flowing-wind/SPI_Slave/tb/README

To perform gate-level sim, copy _lvs.v and _minmax.sdf into current directory.
