flowing-wind/SPI_Slave/doc/SPI_Slave_Design.pptx

## SPI Slave Design

BY Eric Yang 2026.08

## Overview

- Features
  - CPOL=0, CPHA=0
  - MSB first
  - Back-to-back transfer support
  - 8 x 16-bit registers available
  - Read data within the same frame
  - No system clock
  - 24-bit self-defined frame protocol
- Frame Structure (MSB first)
  - [23] RW 0 = write, 1 = read
  - [22:16] ADDR only the low AW bits are decoded, upper bits ignored
  - [15:0] DATA

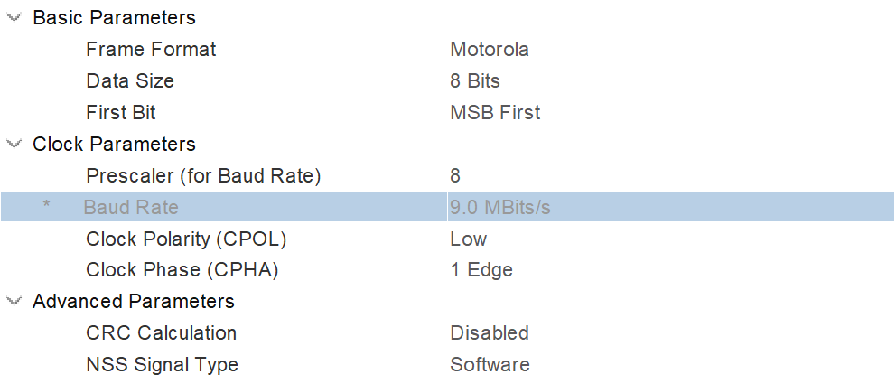
[picture p1: figure]

Easy to communicate with MCU using an 8-bit SPI peripheral.
3 Back-to-back transfers per frame with software NSS control.

## Front-end Design

No system clock:
- No CDC problem

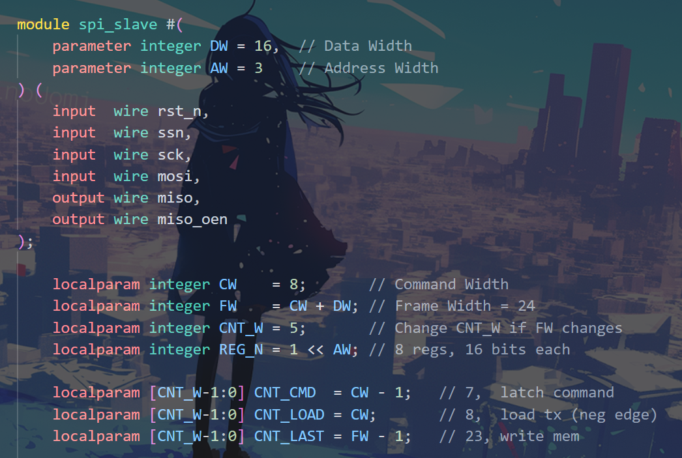
[picture p2: figure]

Design is parameterized –
Easy to customize the frame format,
or modify the number of registers.

SPI Slave Block Diagram

## RTL Simulation

- Simulator: VCS
- Testbench Language: SystemVerilog
- Verification tasks:
  - Reset behavior
  - All zeros/ones transfer
  - Back-to-back transfer
  - Read/Write same addr
  - Read/Write when deselected
  - Randomized multi-frame transfer
  - Functional coverage

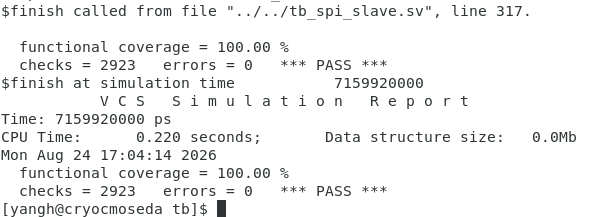
[picture p3: figure]

## Coverage Report

- Functional Coverage
  - Cover both read and write
  - Cover all 8 regs
  - Cover arbitrary addr_hi
  - Cover data with boundary conditions
  - (Cross Cover) All regs should be both read and written
- Line/Cond/Toggle/Branch Coverage
  - All 100% in VCS coverage report

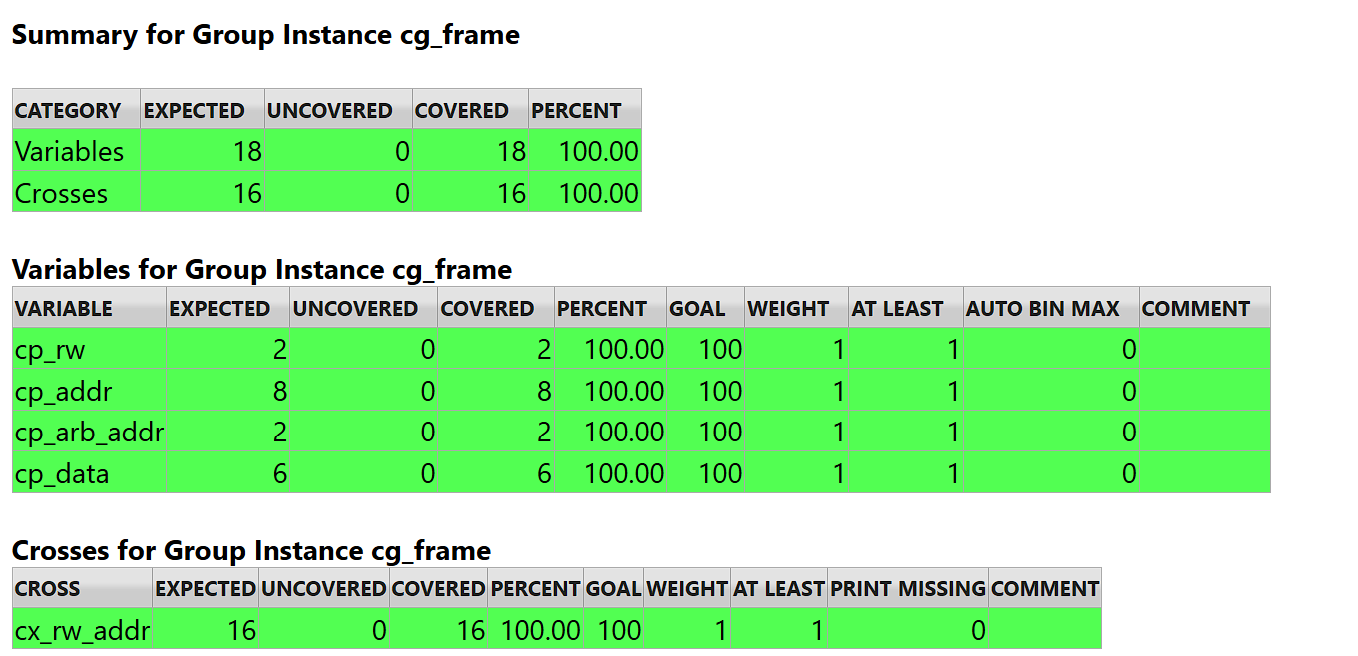
[picture p4: figure]
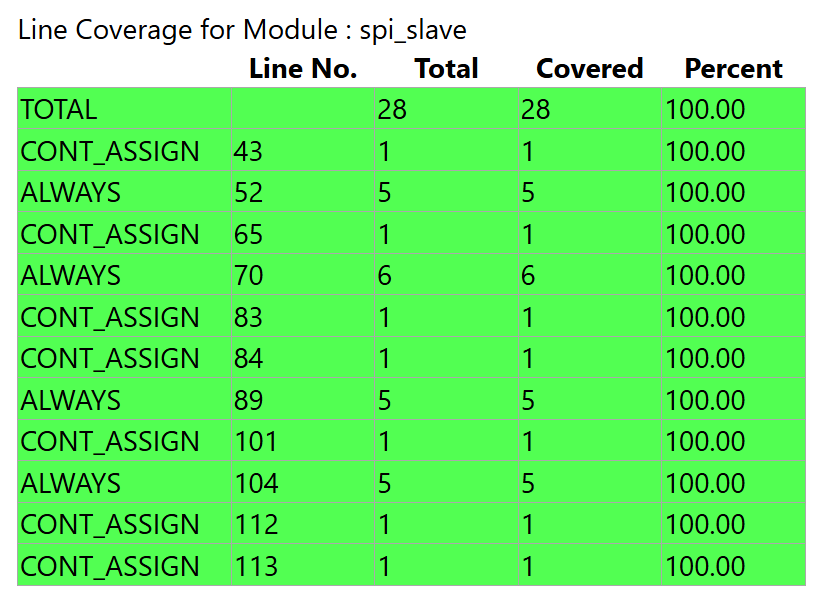
[picture p5: figure]
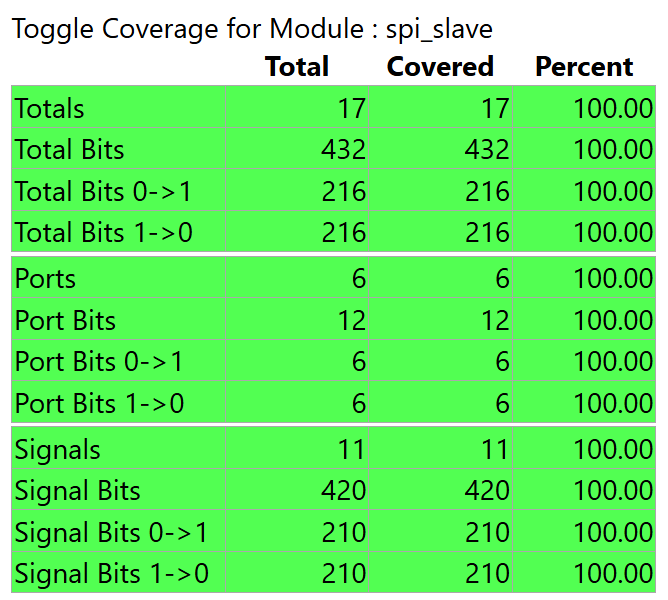
[picture p6: figure]
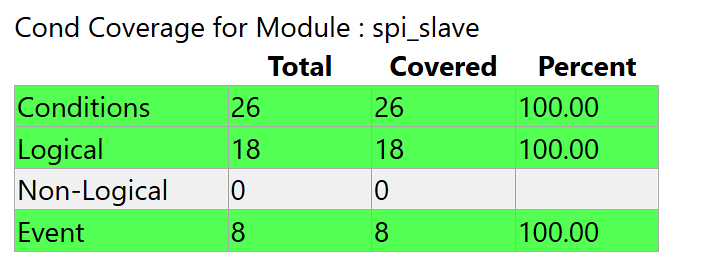
[picture p7: figure]
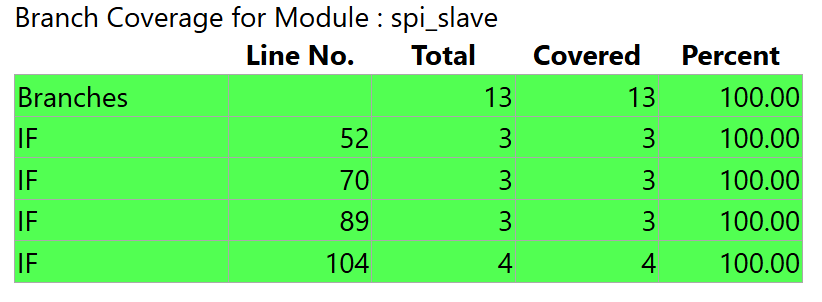
[picture p8: figure]

## Waveforms of Transfers

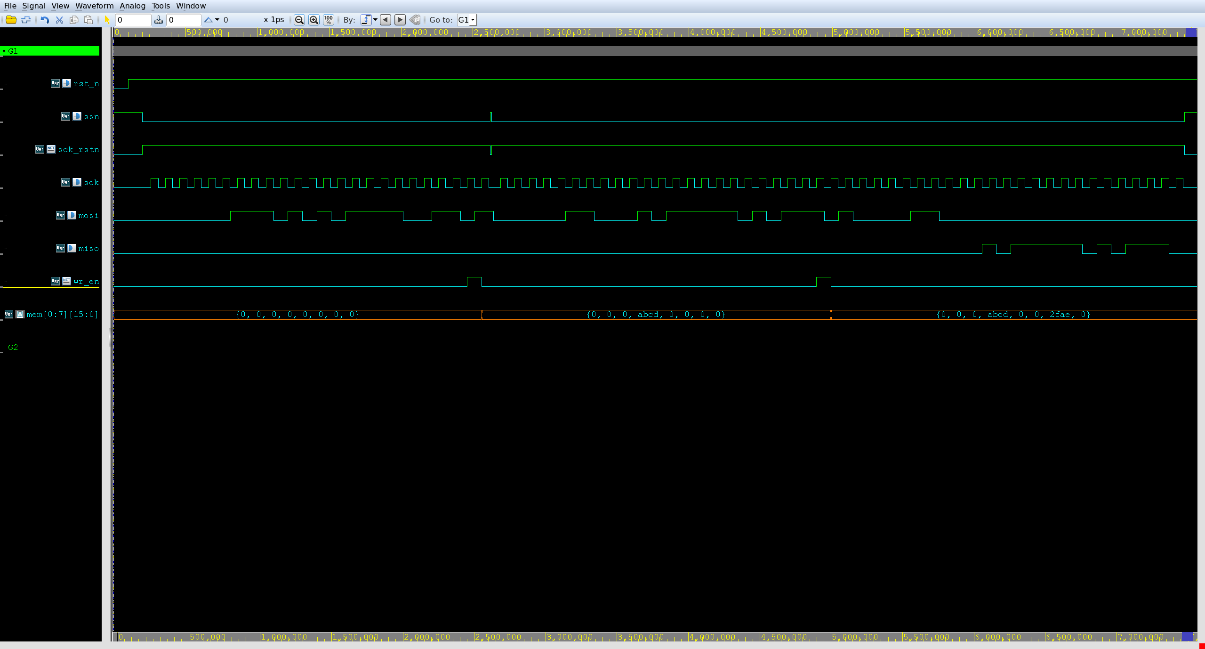
[picture p9: figure]

Read Command

Data Received

Read from 7’d6

Write 16’hABCD to 7’d3

Write 16’h2FAE to 7’d6

Back-to-back transfer

## Back-end Design

- Constraints (Without IO)
  - Clock Frequency: 10MHz
  - Clock Uncertainty: ~10% T
  - Clock Transition: 0.3ns
  - Duty Cycle 60% (60% High, 40% Low)
  - Input/Output delay:
    - Max (setup): Assume 50% CLK_LOW for setup
    - Min (hold): No requirement as a half-cycle remains before sampling
  - Max Fanout: 20

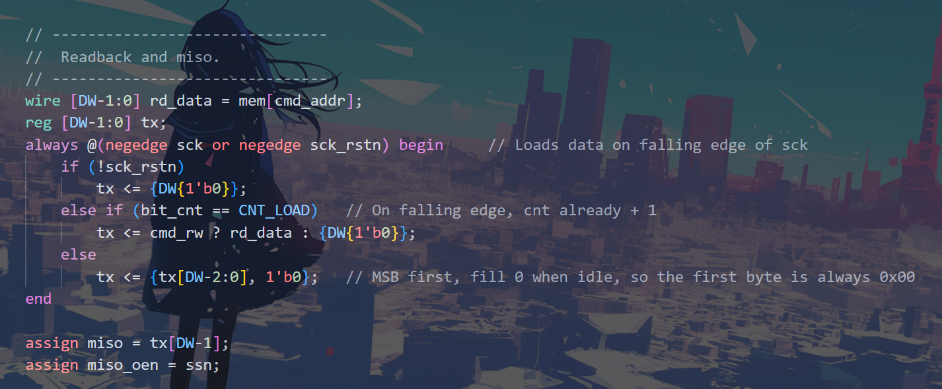
[picture p10: figure]

Data is transmitted at negedge,
but sampled at posedge.
Critical path for output delay (setup).

## DC & FM

- DC Summary
  - No Violation
  - Area: 12014.33 um²
- FM Summary
  - No LAT
  - Verification Succeeded

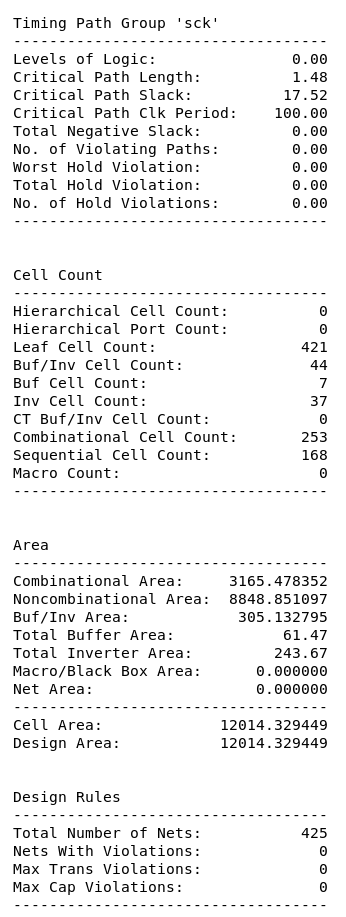
[picture p11: figure]
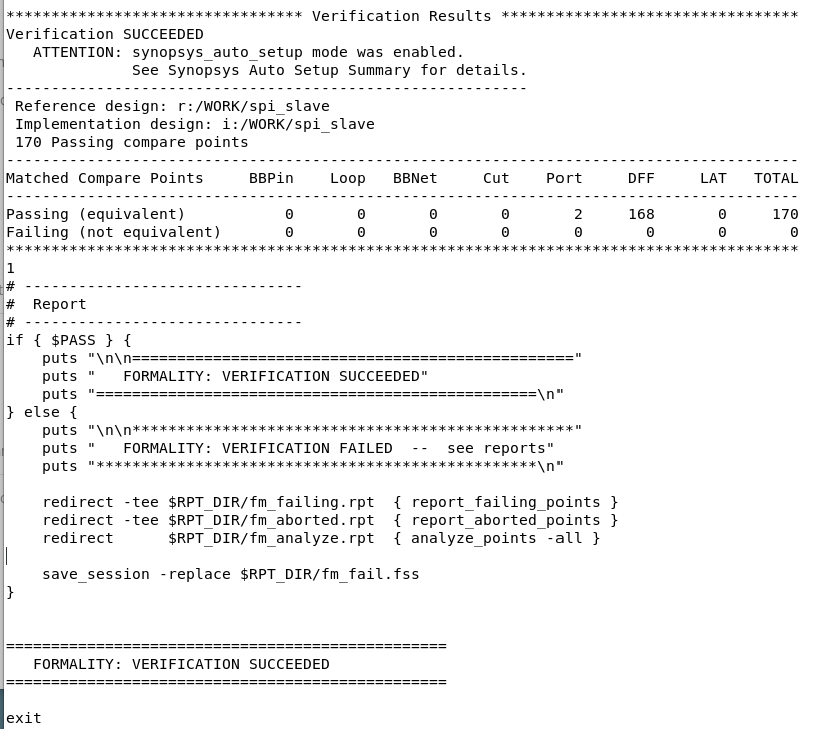
[picture p12: figure]

## Innovus

- Process: TSMC 0.18um
- LIB: tcb018gbwp7t
  - WC: SS/125℃/1.62V for setup
  - BC: FF/ 0℃ / 1.98V for hold
- FloorPlan
  - Die: 294um * 98um
    - DIE_W = 294 = core 270 + 2 x 12 margin
    - DIE_H = 98 = core 80 + 2 x 9 margin
  - Pins: {miso miso_oen mosi sck ssn rst_n}

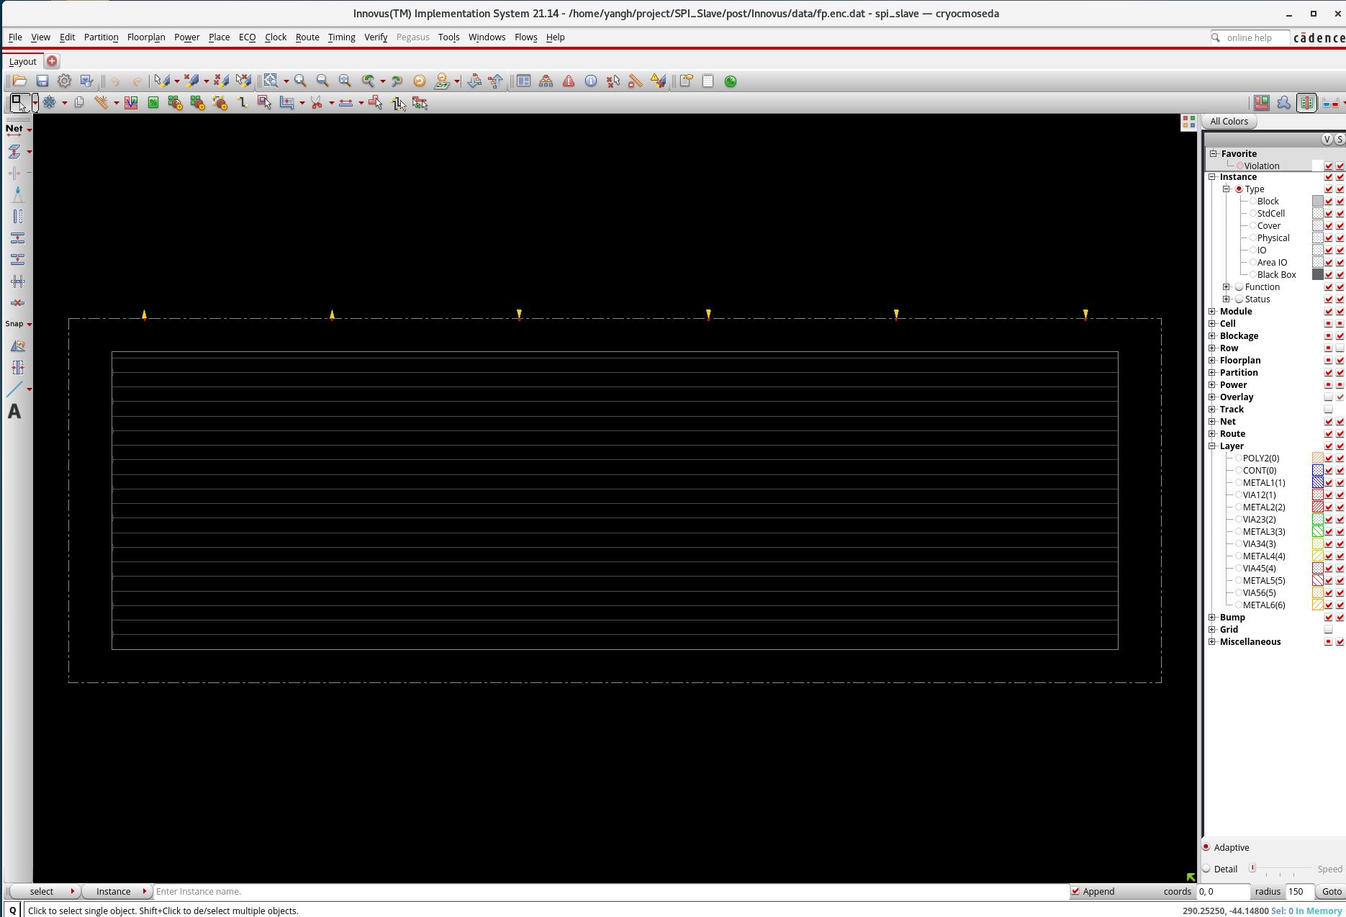
[picture p13: figure]

## Innovus

- Power
  - Power Ring
    - Metal 6 Vertical
    - Metal 5 Horizontal
  - Power Stripe
    - Metal 6 Vertical
    - 4 sets
  - Power Rail
    - Metal 1 Horizontal

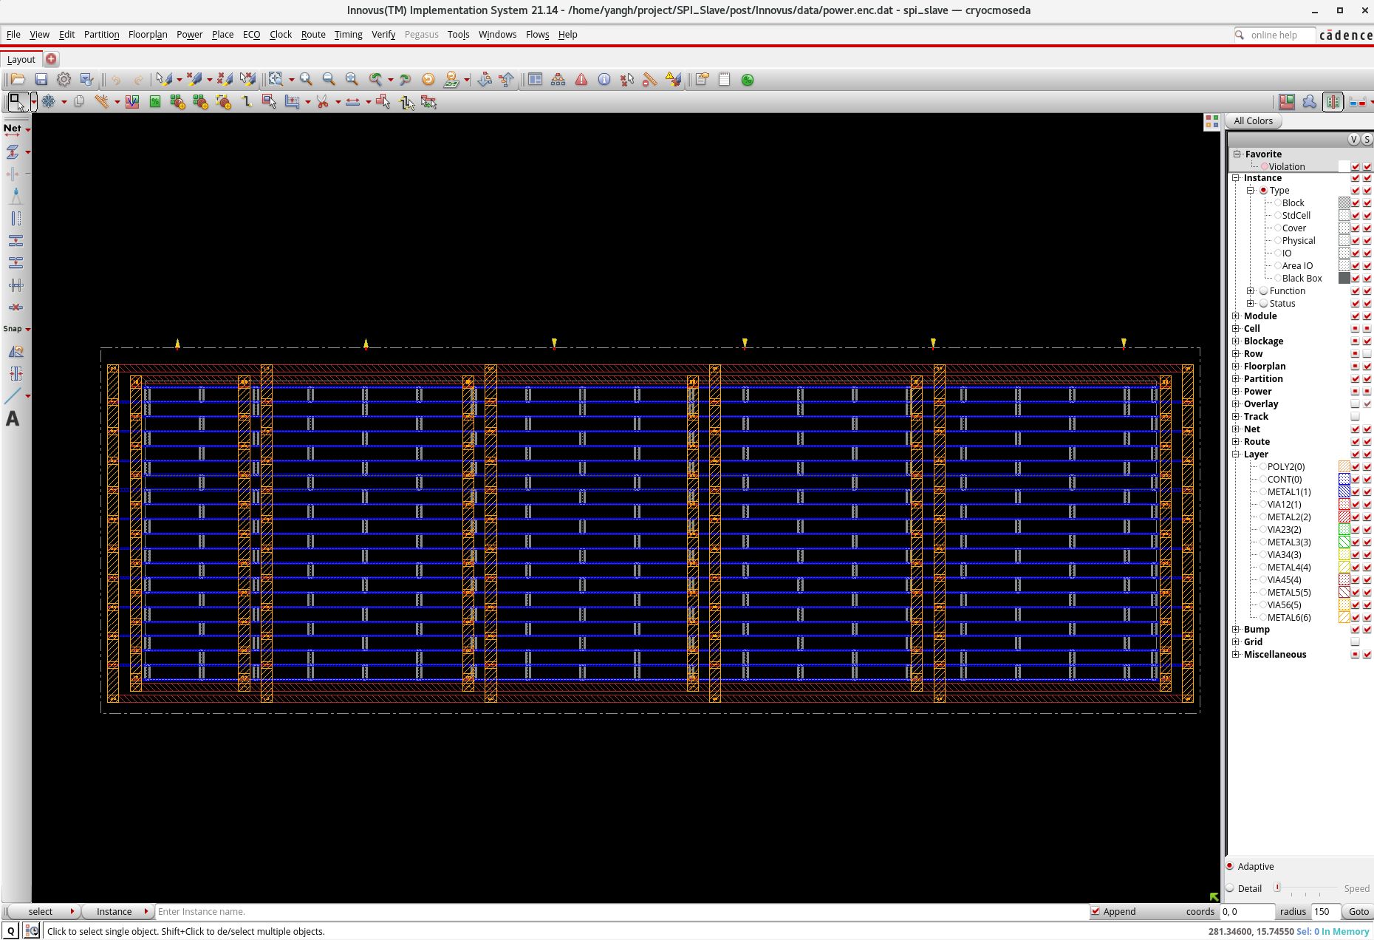
[picture p14: figure]

## Innovus

- Summary
  - Density: 67.928%
    - 100.000% with Fillers
  - Total number of glitch violations: 0

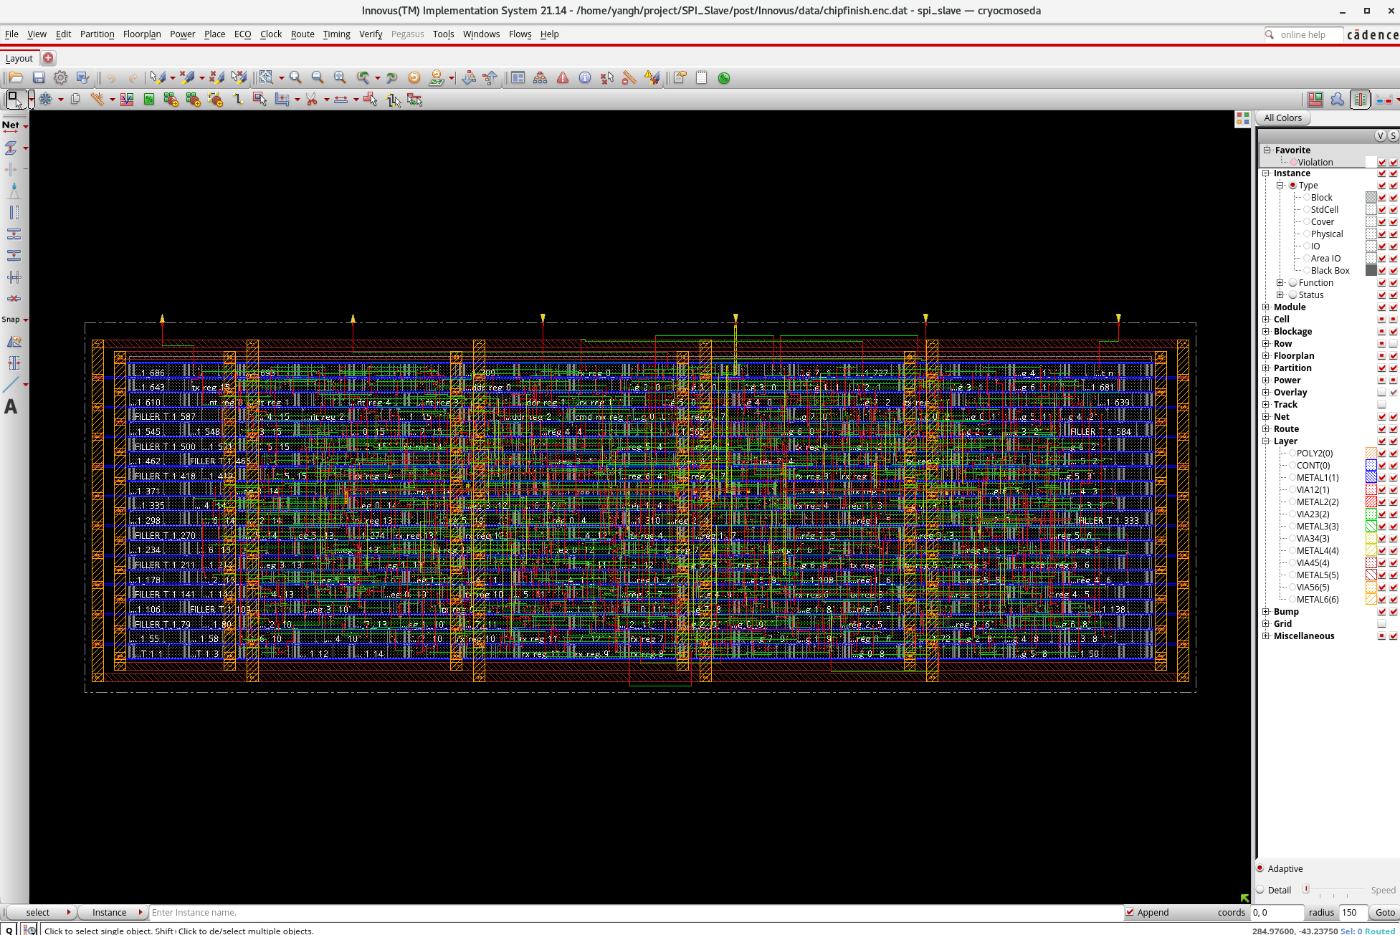
[picture p15: figure]
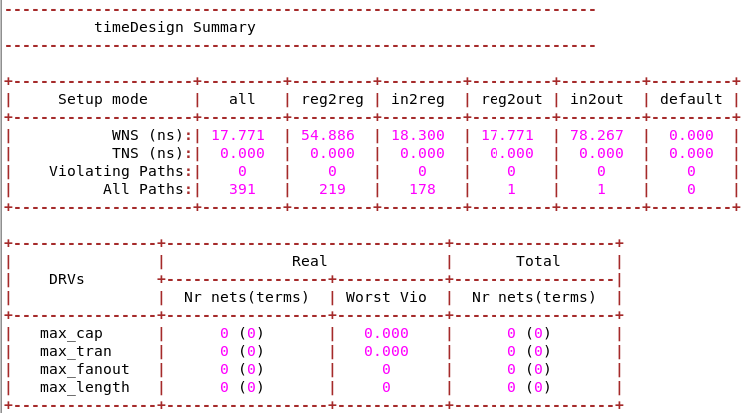
[picture p16: figure]
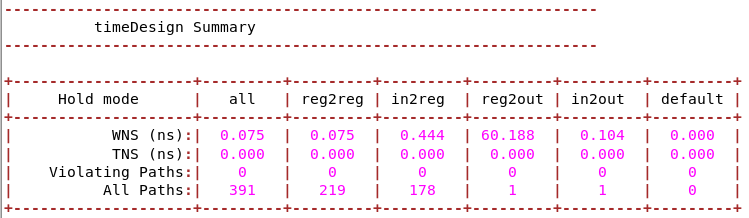
[picture p17: figure]

## IO Plan

- Power IO
  - Pre-drivers & Core
    - 1.8V
  - Post-drivers
    - 3.3V
    - We take PVDD2POC as the
post-driver power supply
  - Power On Control
    - Will explain later

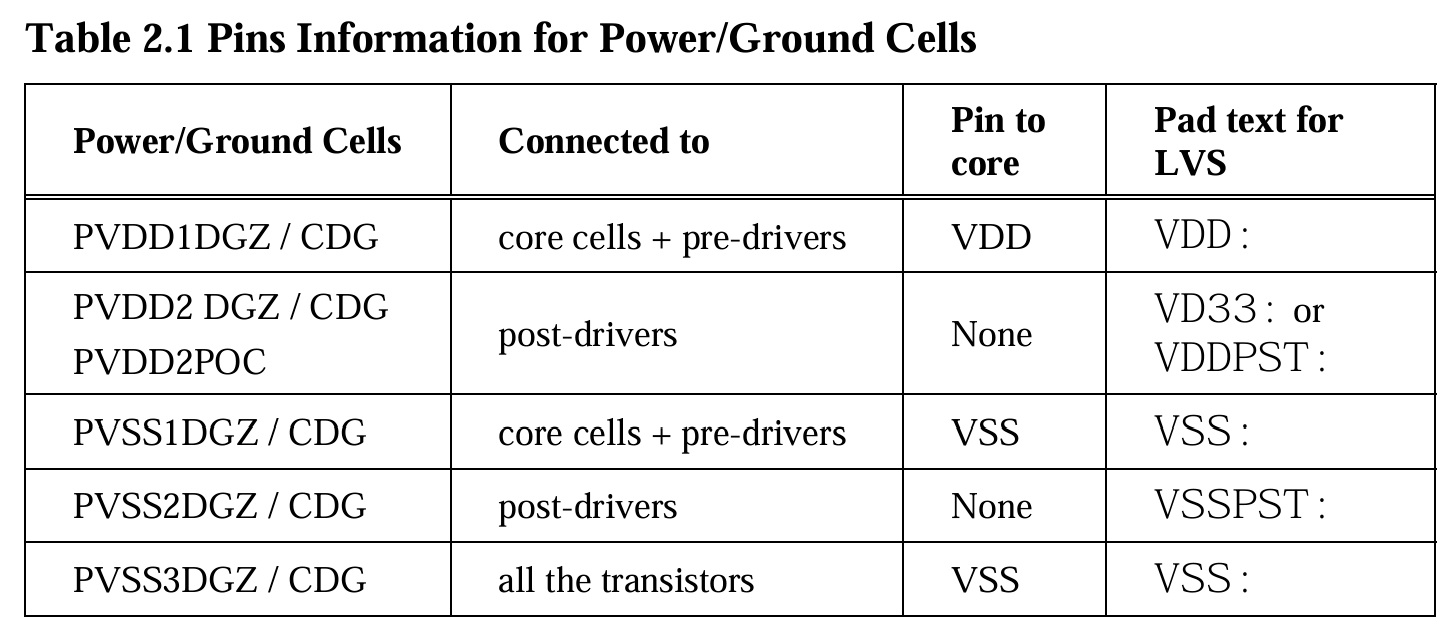
[picture p18: figure]
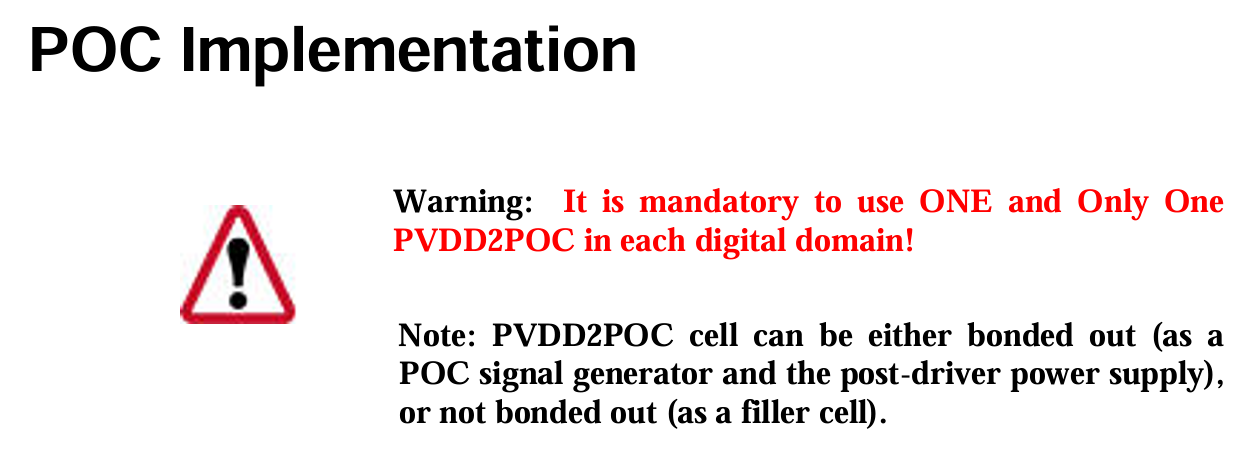
[picture p19: figure]

## IO Plan

- Digital IO
  - Input (PRXW0812SCDG)
    - Pull-up: rst_n, ssn
    - Pull-down: sck, mosi
    - Schmitt Trigger Input
      - For noise immunity
  - Output
    - PRDW0812SCDG
    - With Slew Rate Controlled Output
      - Reduce peak current
    - 8mA output
      - ~7ns edge @20pF, 3.3V

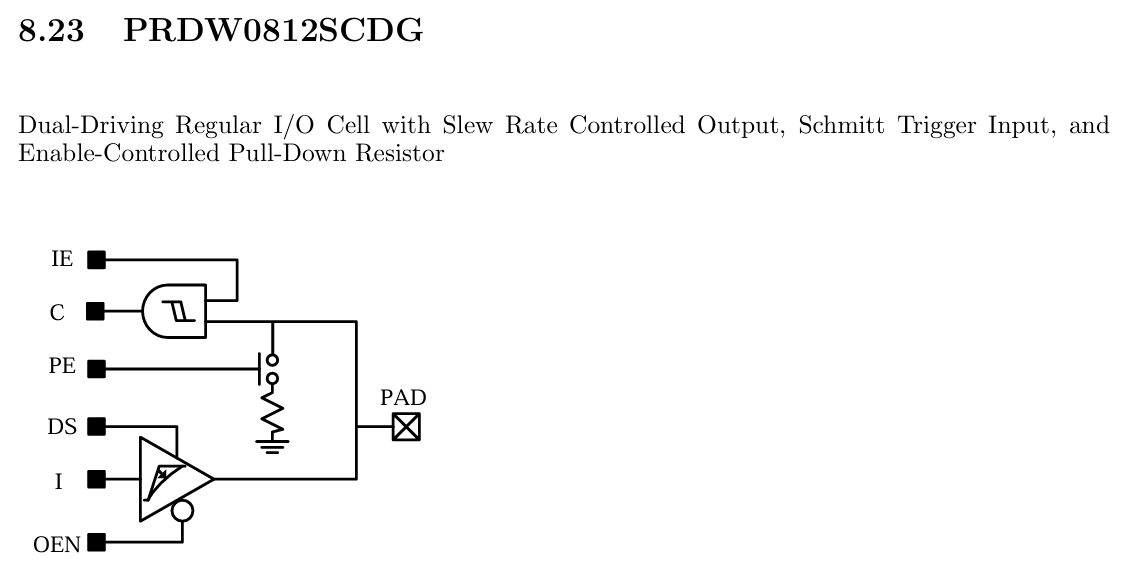
[picture p20: figure]
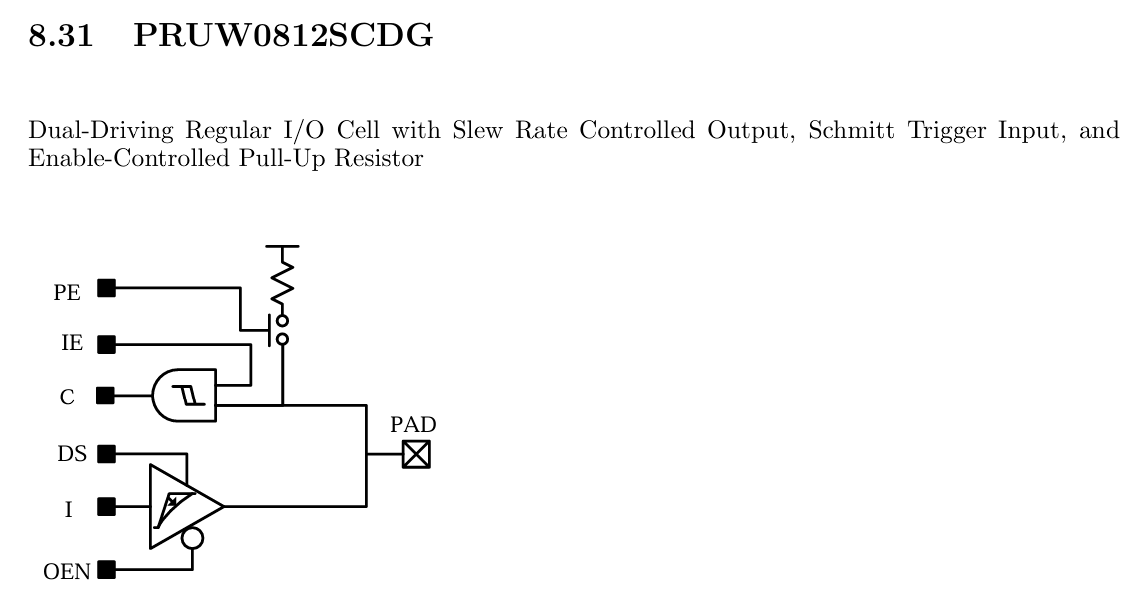
[picture p21: figure]

## Virtuoso Layout

My Part

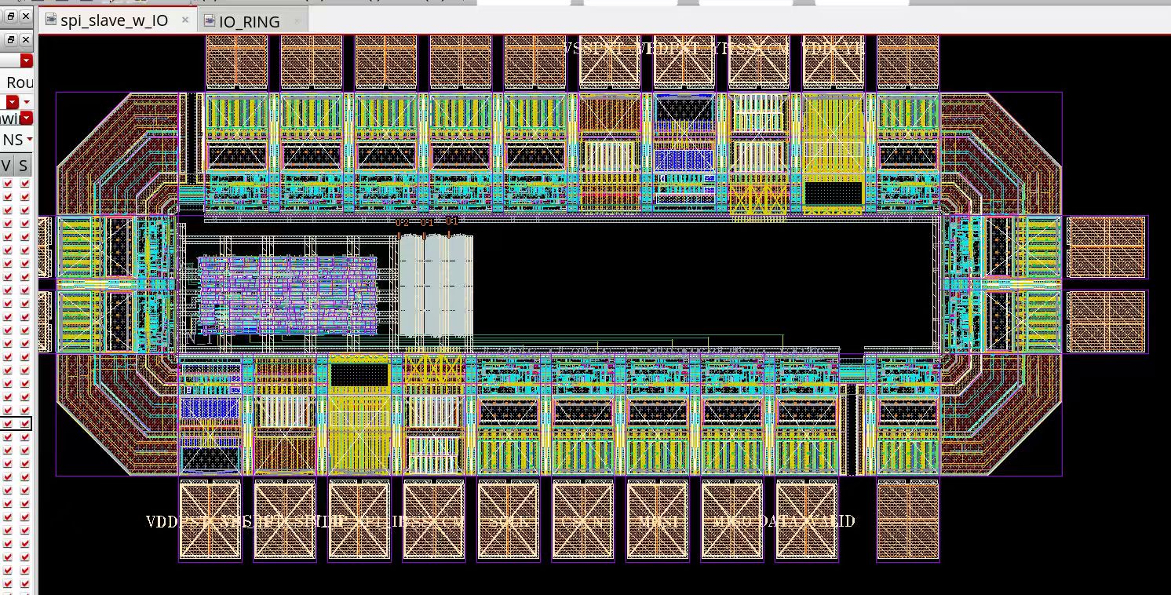
[picture p22: figure]

## Virtuoso Layout

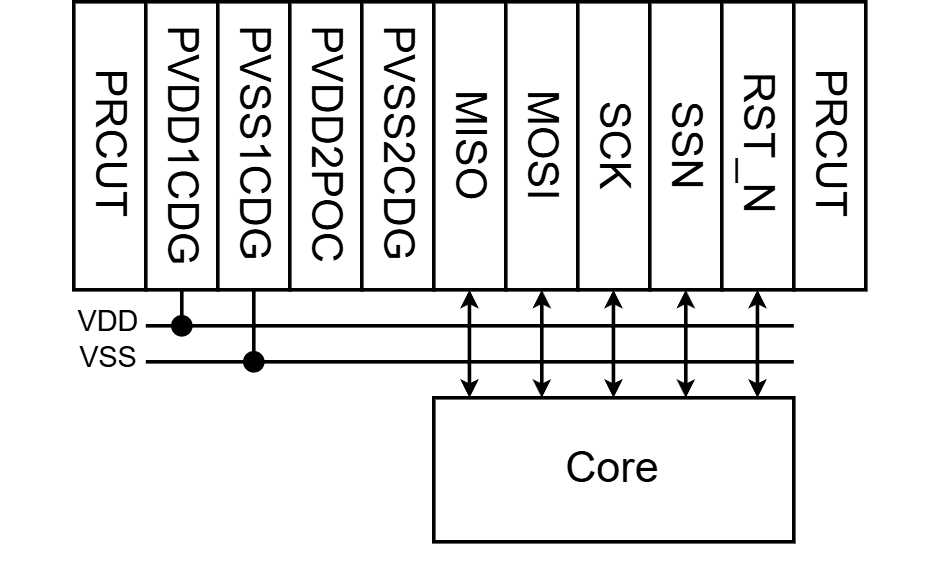
[picture p23: figure]
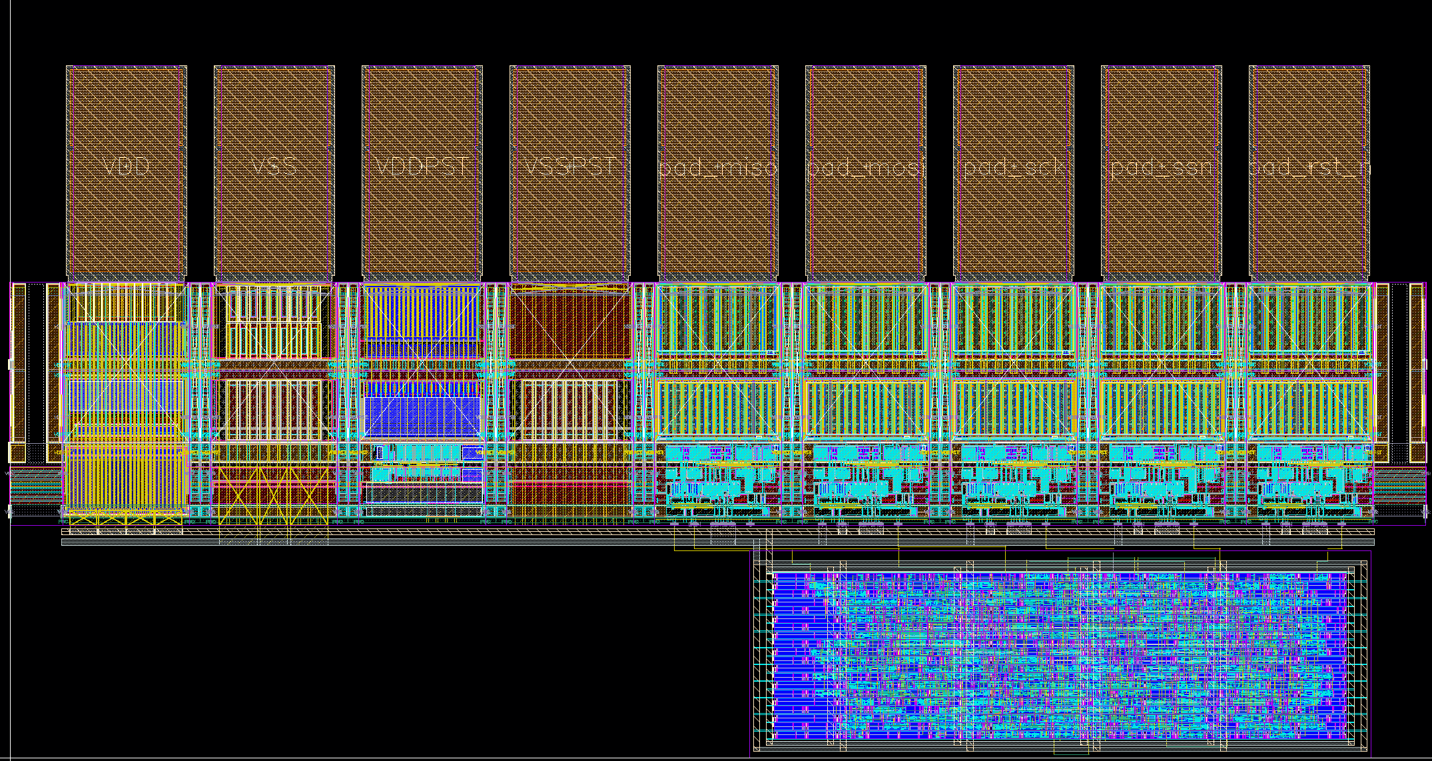
[picture p24: figure]

## LVS & DRC

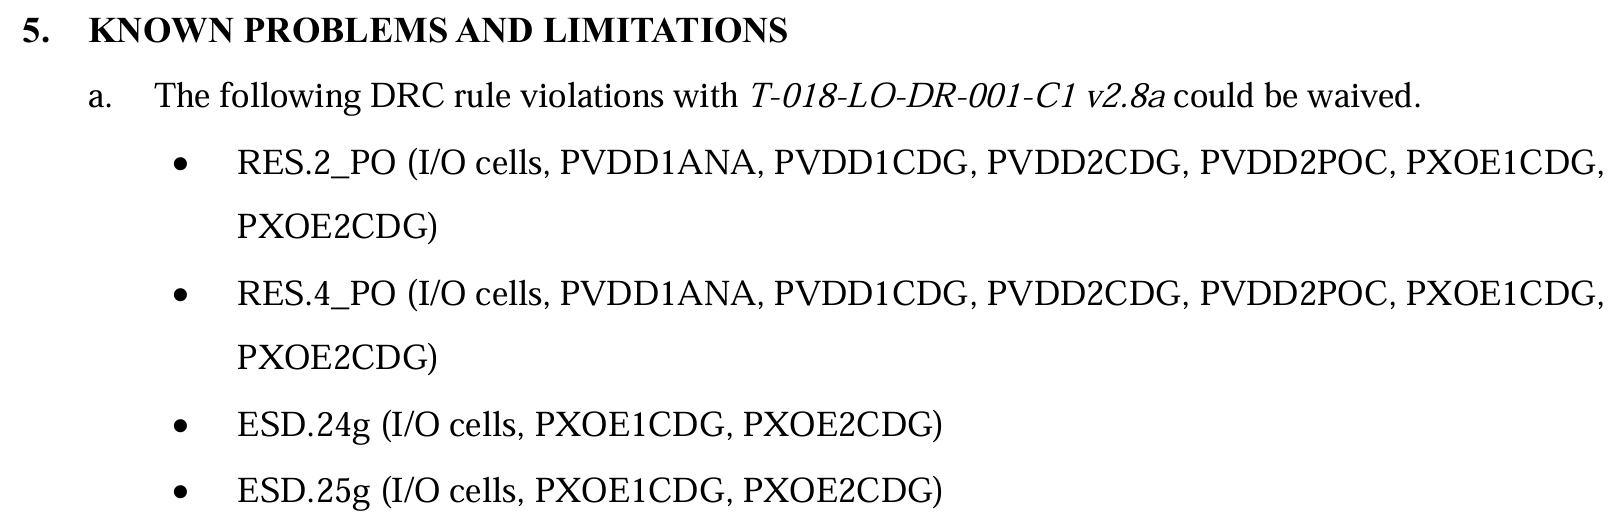
[picture p25: figure]
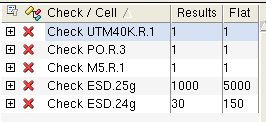
[picture p26: figure]

- LVS
  - All passed
- DRC
  - UTM40K.R.1 { @ Min. density of M6 area >= 30% }
    - Dummy fill by others
  - PO.R.3 { @ Min poly area coverage < 14% }
    - Dummy fill by others
  - M5.R.1 { @ Min M5 area coverage < 30%}
    - Dummy fill by others
  - ESD.24g & ESD.25g
    - Waived due to rn_tpd018nv_280a.pdf

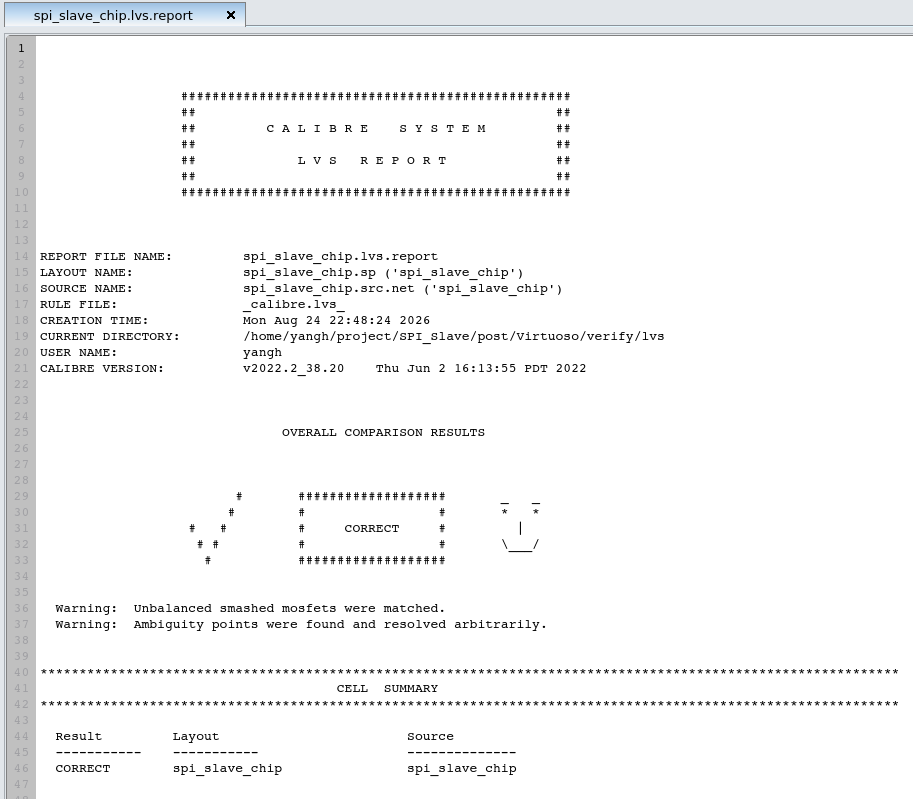
[picture p27: figure]

## Gate-level Simulation

- Simulator: VCS
- Testbench Language: SystemVerilog
- Same tasks with SDF annotation
- Max/Min all passed

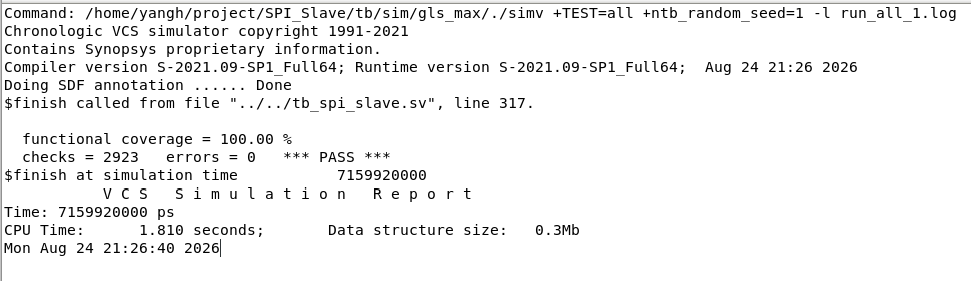
[picture p28: figure]
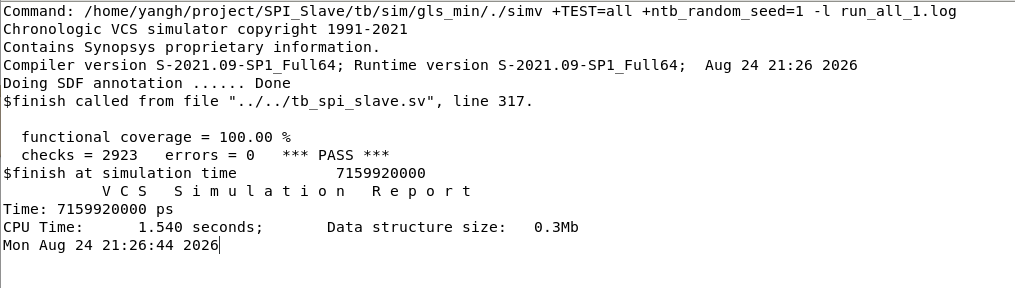
[picture p29: figure]

## Post-layout Simulation

- POC test
- Why POC?
  - The power-up sequence between rails is not guaranteed
  - It is common for the IO supply (3.3 V) to come up before the core supply (1.8 V)
  - POC is required to clamp the IO into a known state (typically high-Z) until the core supply is stable

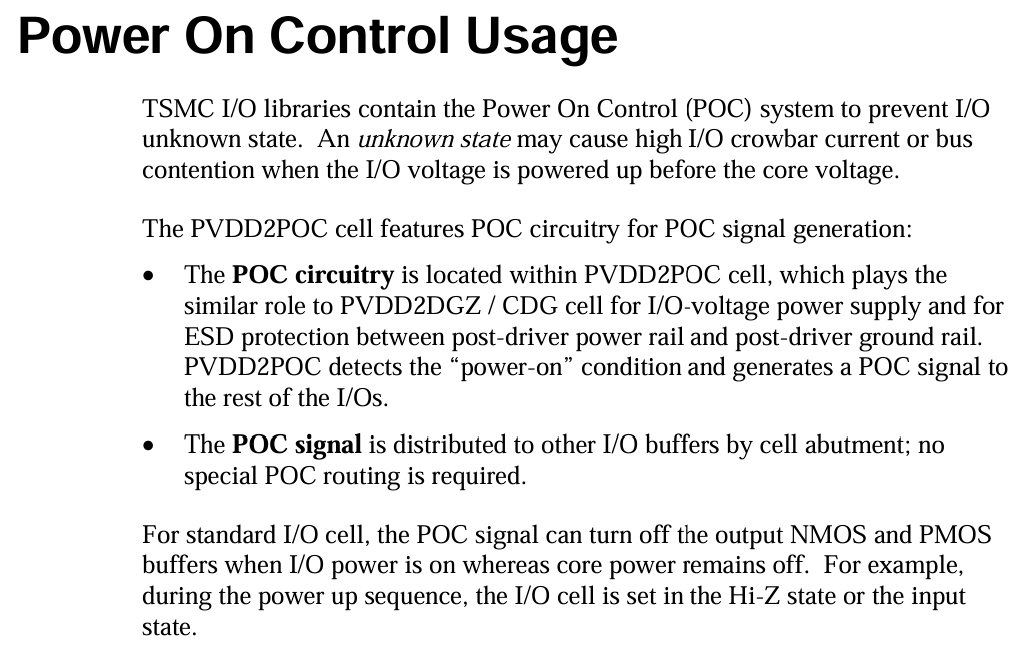
[picture p30: figure]
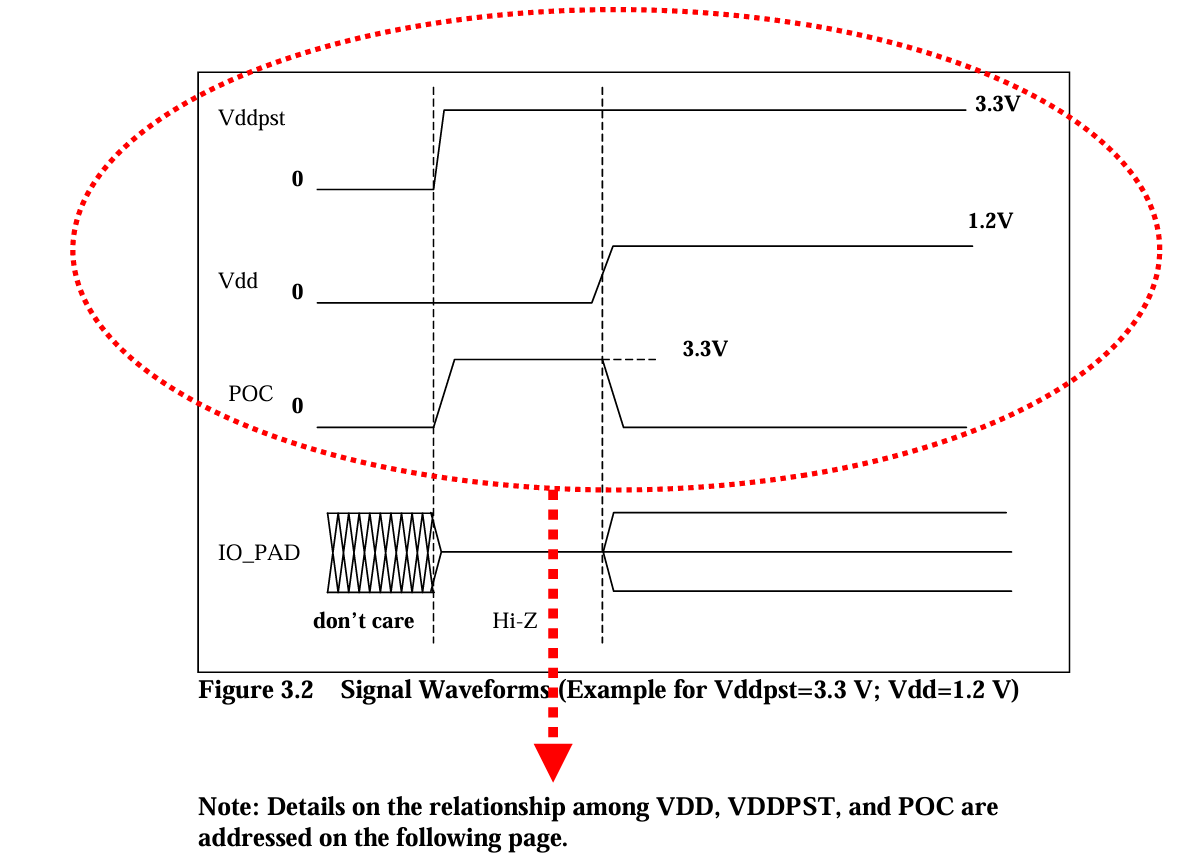
[picture p31: figure]
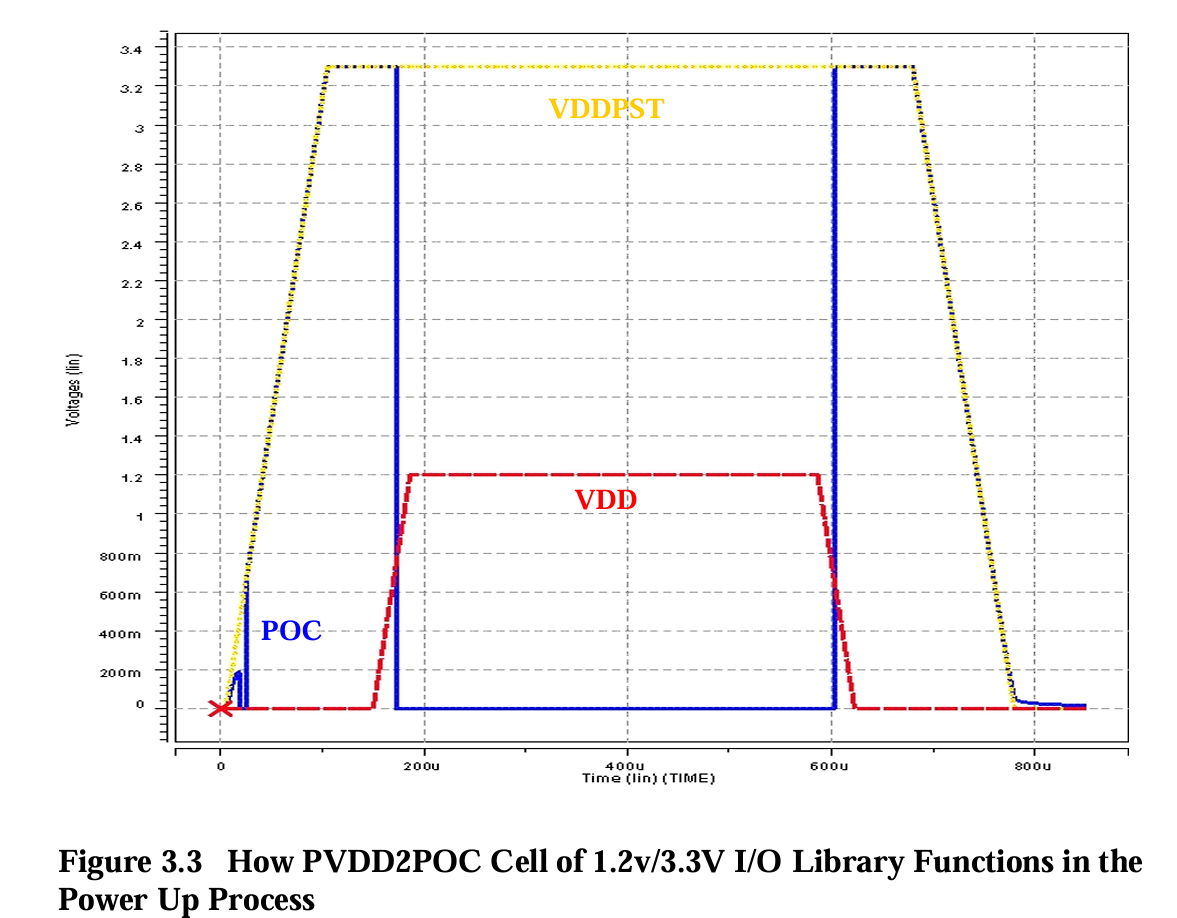
[picture p32: figure]

## POC Test

- How to test high-Z:
  - Connect IO to 1.65V with 1M resistor
  - If pad is high-Z,
it’ll be clamped at 1.65V
  - If pad is controlled by the core,
it’ll be either near 3.3V / 0V

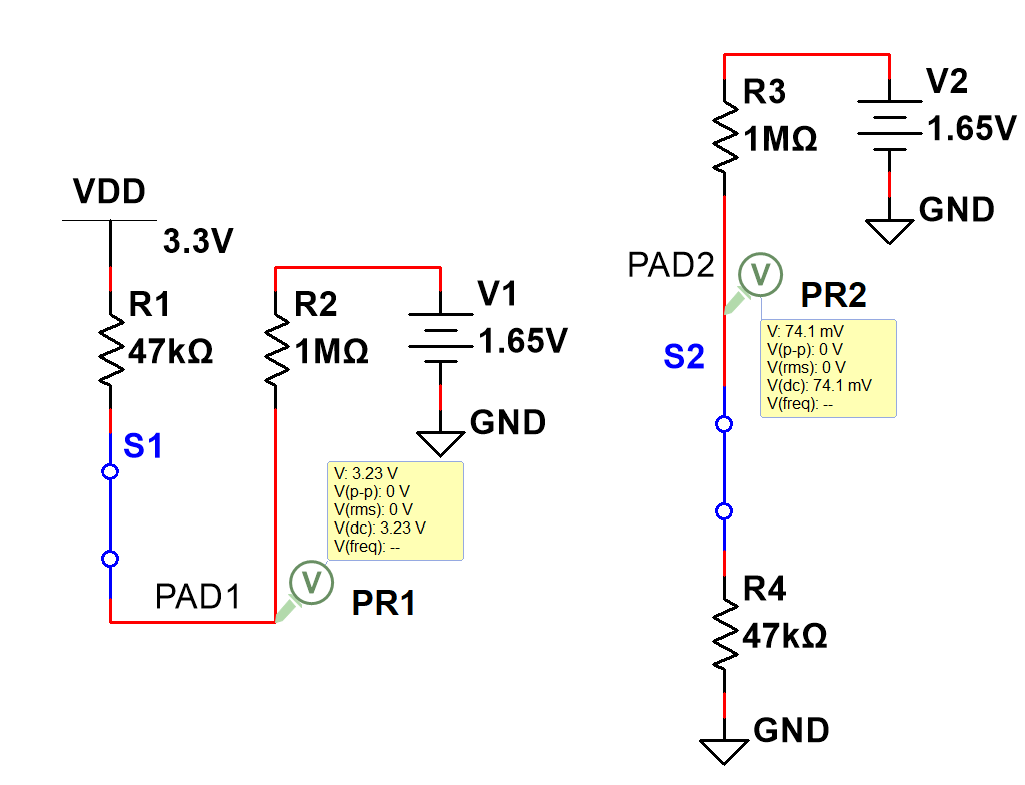
[picture p33: figure]
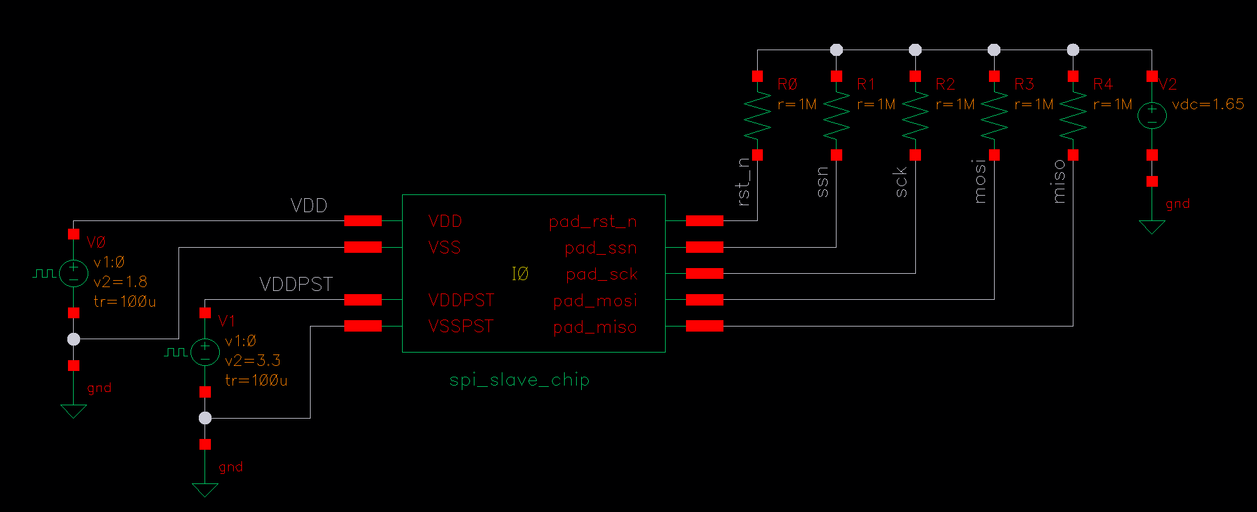
[picture p34: figure]

## Slide 20

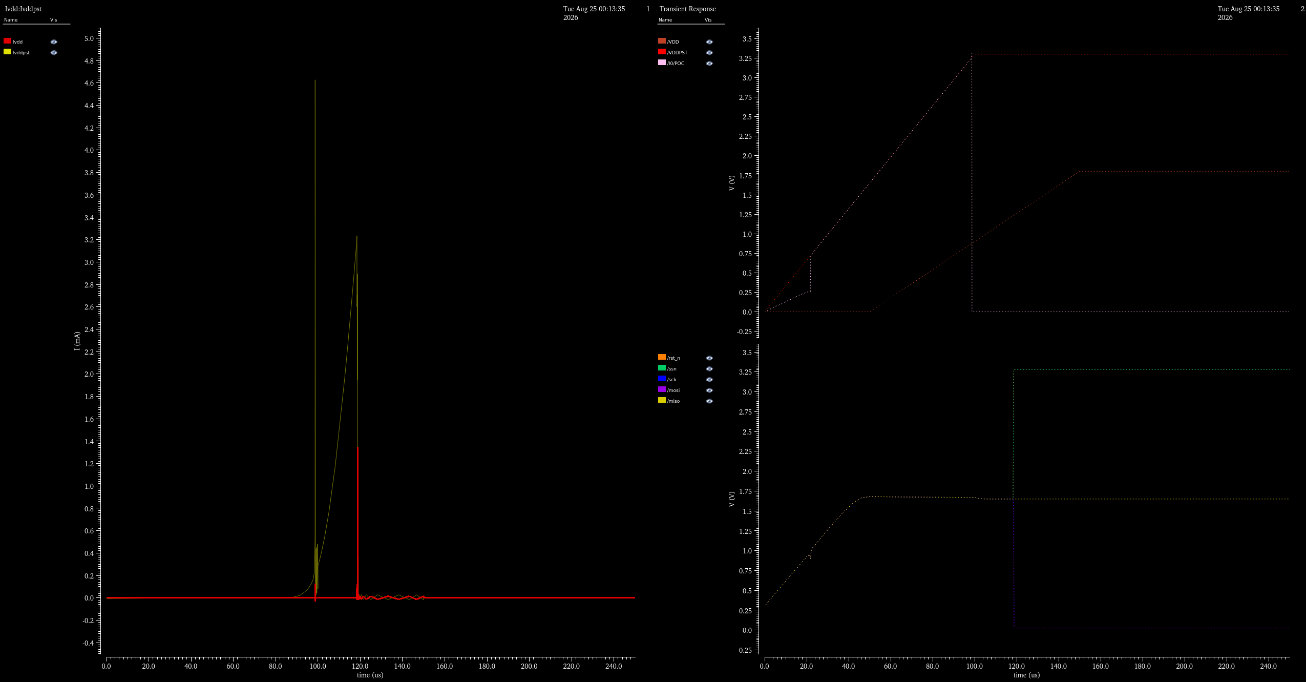
[picture p35: figure]

POC Test @ tt/1.8V/3.3V/27°C

POC cutoff
State switch

POC cutoff

VDD is not large enough to turn off
VDDPST-PMOS-NMOS-GND
Current rises

POC on

50us late for VDD

PAD is controlled by core

Level shifter on
Current off

Level shifter on Switching current

ssn rst_n high

Controlled by POC

miso high-Z

sck mosi low

## Critical Timings

- tEN: Output enable time
  - Maximum delay from the falling edge of ssn until miso leaves the high-Z state and is actively driven
  - Measured from the 50% point of the ssn waveform to the 50% point of the miso waveform

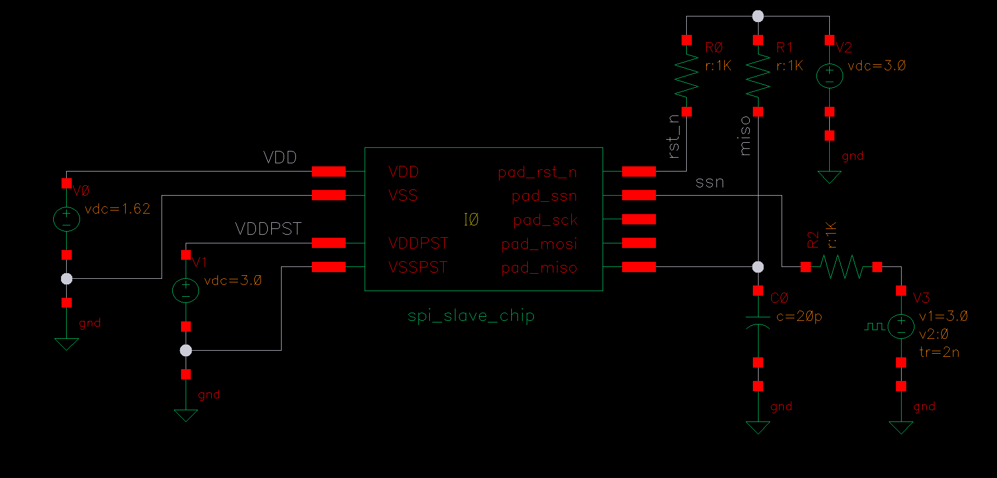
[picture p36: figure]

## Slide 22

tEN = 6.02ns @ ss/1.62V/3.0V/125℃, CL=20pF

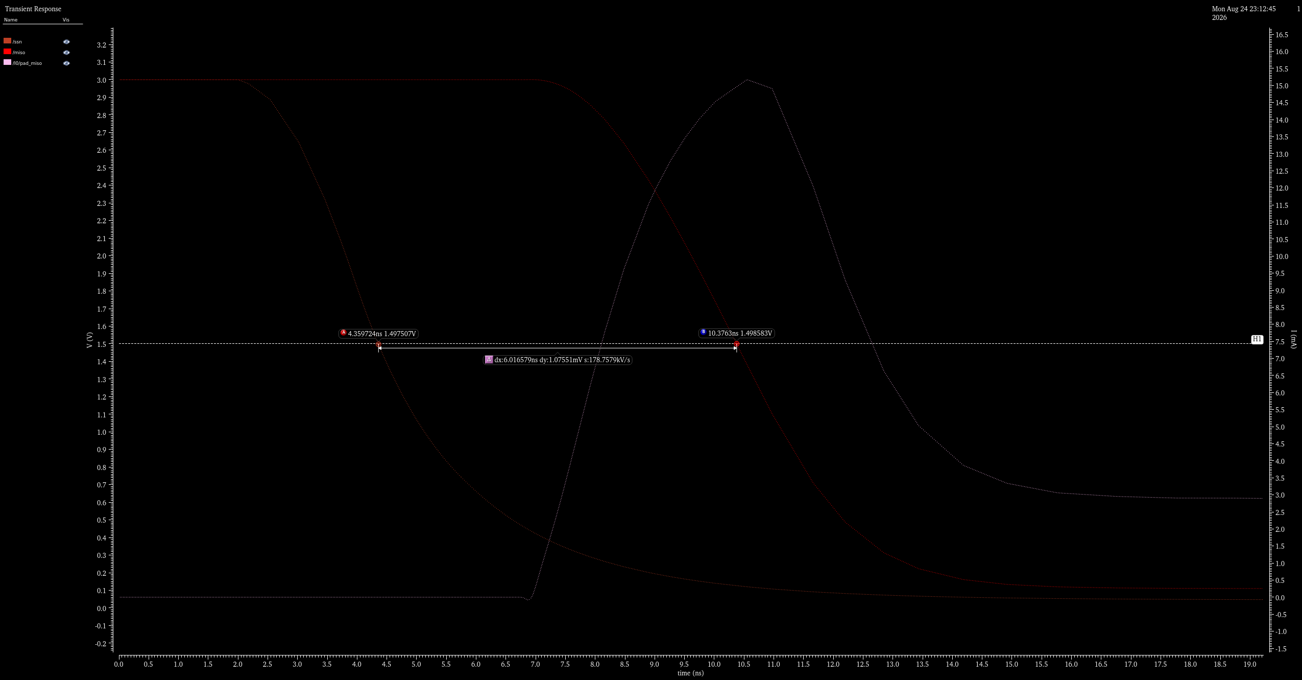
[picture p37: figure]

## Critical Timings

- tDIS: Output disable time
  - Maximum delay from the rising edge of ssn until miso returns to the high-Z state
  - Measured the current from stable to approximately 0
    - Time for miso to return to high-Z voltage is determined by the external R and CL

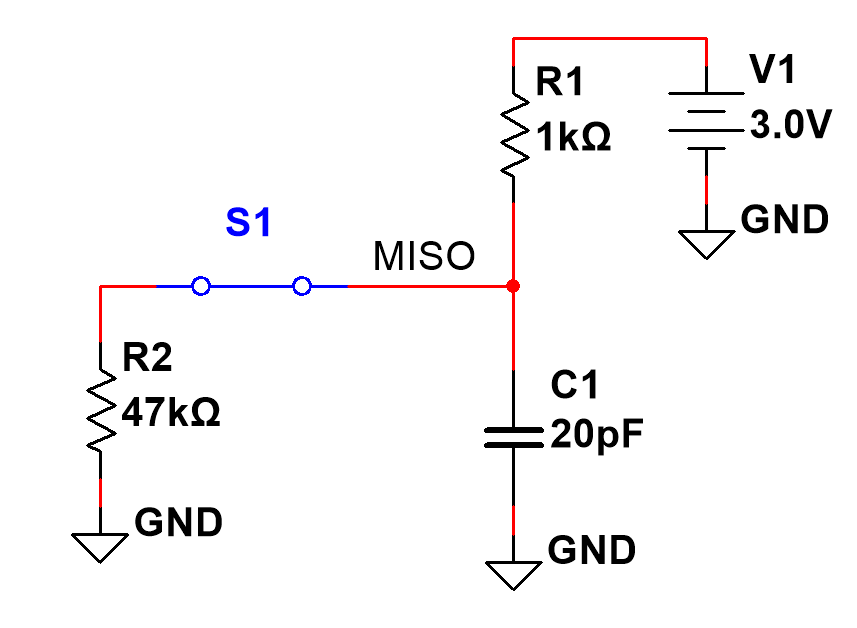
[picture p38: figure]

miso active

current

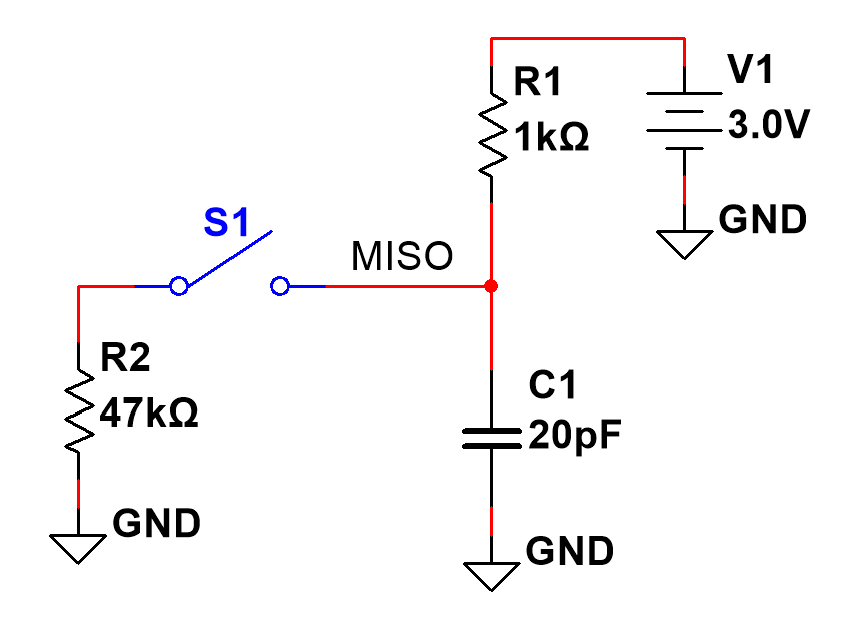
[picture p39: figure]

miso high-Z

current

## Slide 24

tDIS = 2.64ns @ ss/1.62V/3.0V/125℃, CL=20pF

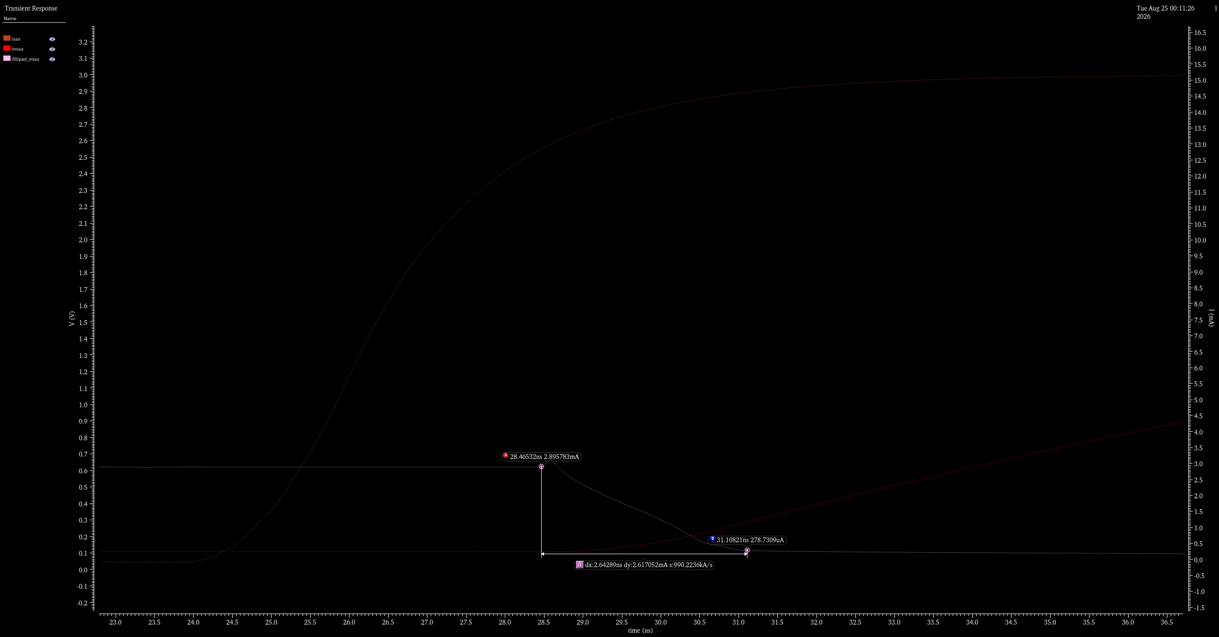
[picture p40: figure]

## Critical Timings

- tV: Data output valid time
  - Maximum delay from the falling edge of sck to miso becoming valid
  - Measured from the 50% point of the sck waveform to the 50% point of the miso waveform

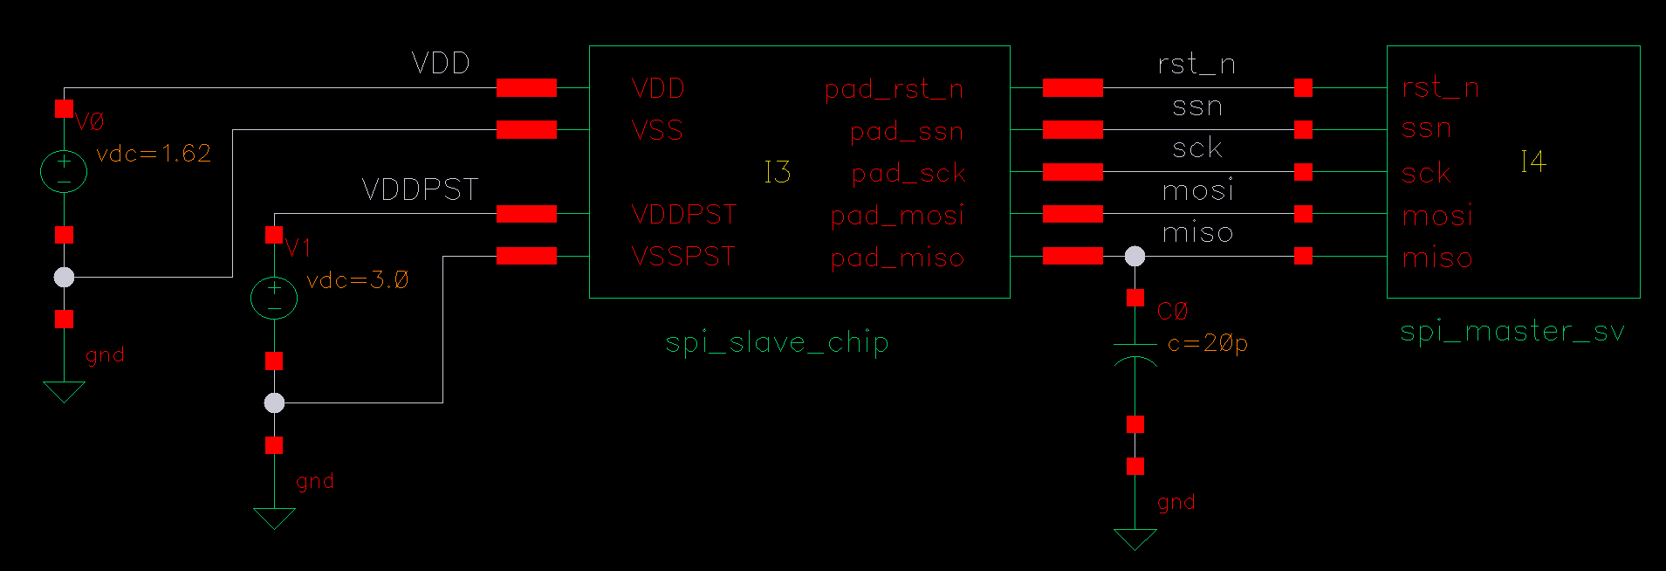
[picture p41: figure]

## Slide 26

tV = 6.26ns @ ss/1.62V/3.0V/125℃, CL=20pF

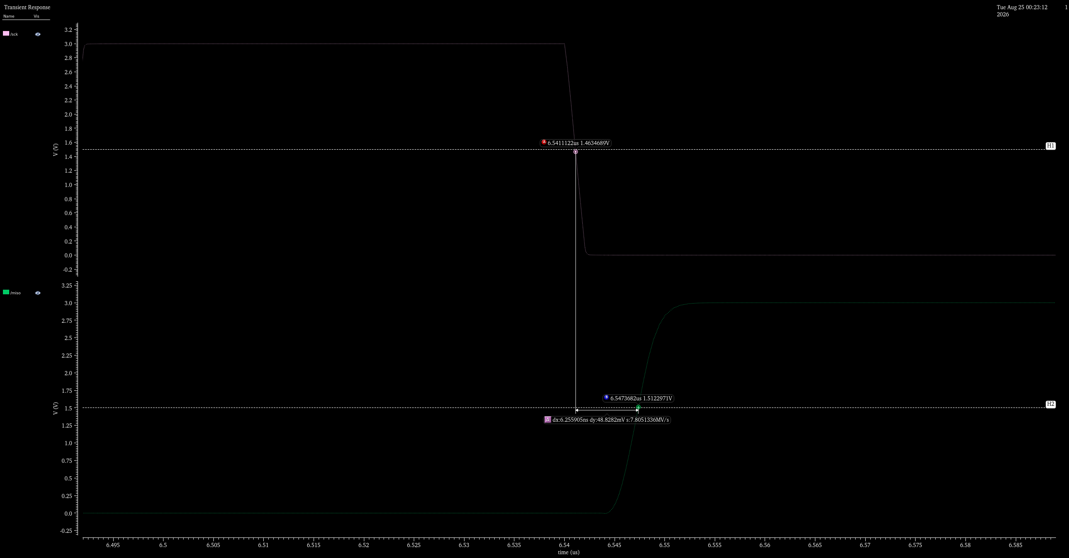
[picture p42: figure]

## AMS Simulation

- Write an SPI Master in SystemVerilog
- Connect to SPI Slave
- Run AMS to check the transfer waveforms

## Slide 28

AMS Simulation Passed @ ss/1.62V/3.0V/125℃, CL=20pF

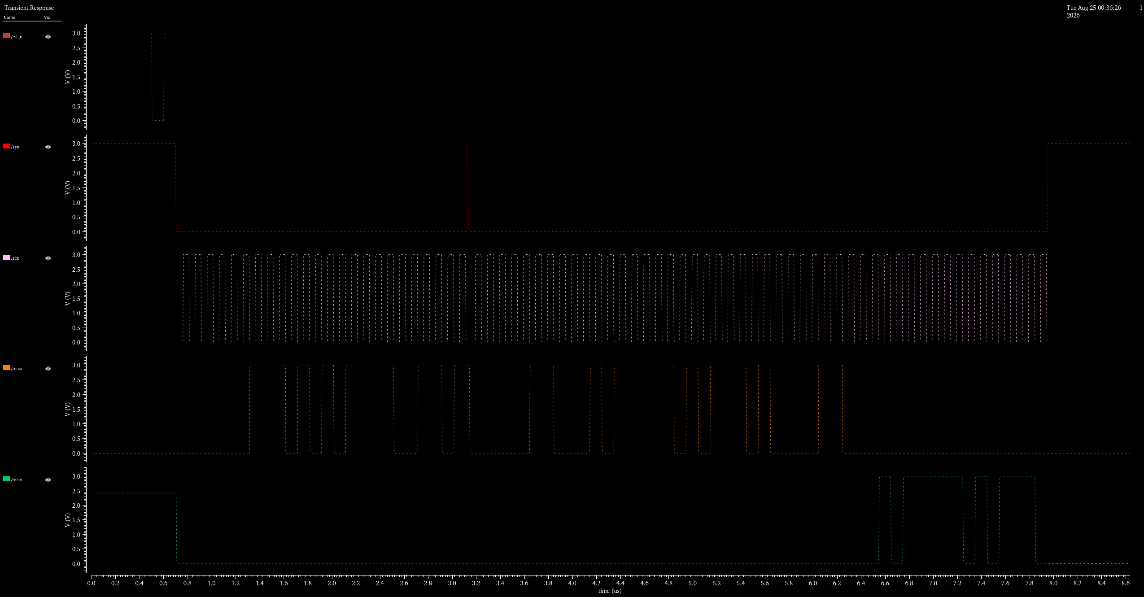
[picture p43: figure]

## ELECTRICAL CHARACTERISTICS

PARAMETER | SYMBOL | DESCRIPTION | SPEC | | | UNIT
| | | MIN | TYP | MAX
IO Supply | VDDPST | | 3.0 | 3.3 | 3.6 | V
Core Supply | VDD | | 1.62 | 1.8 | 1.98 | V
Power-on Current | Ipk | | | 0.1 | 6 | mA
Load Capacitance | CL | | | 20 | | pF
Clock Period | tSCK | | | 100 | | ns
ssn Setup/Hold Time | tSSH /tSSN | Innovus STA & testbench verified | | 10 | | ns
Minimum ssn High Time | tIDLE | Innovus STA & testbench verified | | 10 | | ns
Output Enable Time | tEN | ss/1.62V/3.0V/125℃, 20pF | | | 7 | ns
Output Disable Time | tDIS | ss/1.62V/3.0V/125℃, 20pF | | | 3 | ns
Data Output Valid Time | tV | ss/1.62V/3.0V/125℃, 20pF | | | 7 | ns

## MISC

- Resistor/Diode mismatches in IO library have all been fixed,
all IOs in the library are now available
- All scripts (updated devicemap and cellmap) are included in tsmc18/Digital/README
- Check my smb_share to use the updated version

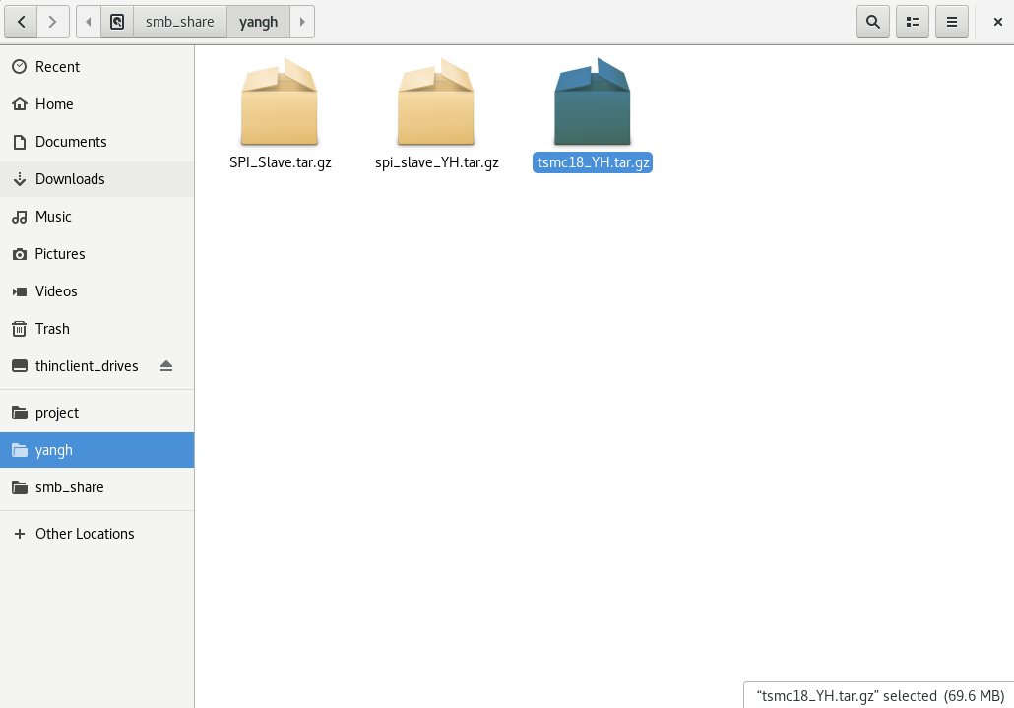
[picture p44: figure]
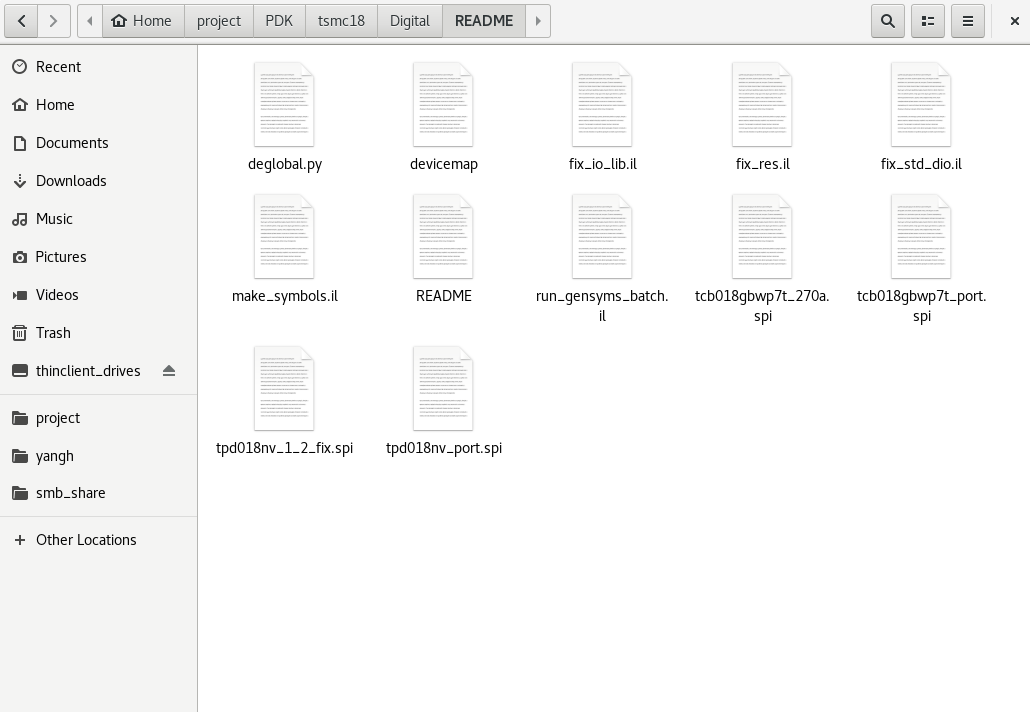
[picture p45: figure]

## Slide 31

Thanks!

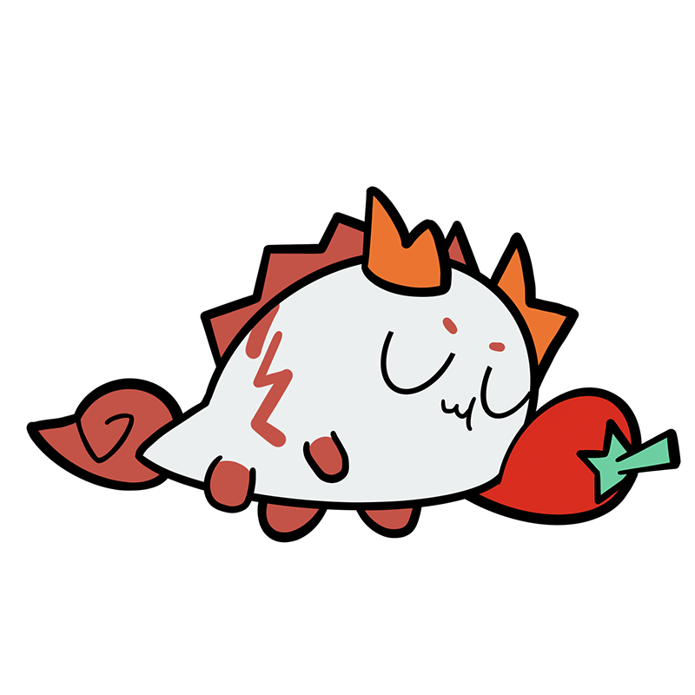
[picture p46: figure]
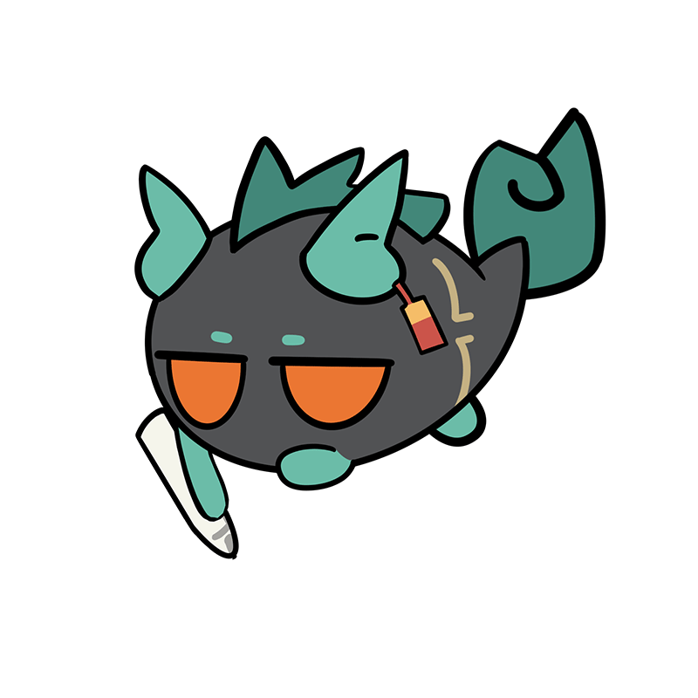
[picture p47: figure]
