flowing-wind/SPI_Slave/(list of files, drawings)

Other design files:
doc/resource/high-z_demo.ms14
doc/resource/ssn_miso_demo.ms14
