flowing-wind/SPI_Slave/rtl/spi_slave_chip.v

// ============================================================================
//  spi_slave_chip.v     v1.0
//  
//  SPI SLAVE CHIP   BY Eric Yang    2026.08
// ============================================================================

module spi_slave_chip (
    inout  wire     VDD,
    inout  wire     VSS,
    inout  wire     VDDPST,
    inout  wire     VSSPST,

    inout  wire     pad_rst_n,
    inout  wire     pad_ssn,
    inout  wire     pad_sck,
    inout  wire     pad_mosi,
    inout  wire     pad_miso
);
    wire POC;
    wire rst_n_i, ssn_i, sck_i, mosi_i;
    wire miso_o, miso_oen;

    // ---- power pads ----
    PVDD1CDG  u_pvdd1 (.VDD(VDD), .VSS(VSS), .VSSPST(VSSPST));
    PVSS1CDG  u_pvss1 (.VSS(VSS), .VDDPST(VDDPST), .VSSPST(VSSPST));
    PVDD2POC  u_poc   (.VDDPST(VDDPST), .VDD(VDD), .VSS(VSS), .VSSPST(VSSPST), .POC(POC));
    PVSS2CDG  u_pvss2 (.VSSPST(VSSPST), .VDDPST(VDDPST));

    spi_slave u_core (
        .VDD        (VDD),
        .VSS        (VSS),

        .rst_n      (rst_n_i),
        .ssn        (ssn_i),
        .sck        (sck_i),
        .mosi       (mosi_i),
        .miso       (miso_o),
        .miso_oen   (miso_oen)
    );

    // ---- inputs ----
    PRUW0812SCDG u_pad_rst_n (
        .PAD (pad_rst_n), .C (rst_n_i),
        .I   (VSS), .OEN (VDD), .IE (VDD), .PE (VDD), .DS (VDD),
        .VDD (VDD), .VSS(VSS), .VDDPST(VDDPST), .VSSPST(VSSPST), .POC(POC)
    );

    PRUW0812SCDG u_pad_ssn (
        .PAD (pad_ssn), .C (ssn_i),
        .I   (VSS), .OEN (VDD), .IE (VDD), .PE (VDD), .DS (VDD),
        .VDD (VDD), .VSS(VSS), .VDDPST(VDDPST), .VSSPST(VSSPST), .POC(POC)
    );

    PRDW0812SCDG u_pad_sck (
        .PAD (pad_sck), .C (sck_i),
        .I   (VSS), .OEN (VDD), .IE (VDD), .PE (VDD), .DS (VDD),
        .VDD (VDD), .VSS(VSS), .VDDPST(VDDPST), .VSSPST(VSSPST), .POC(POC)
    );

    PRDW0812SCDG u_pad_mosi (
        .PAD (pad_mosi), .C (mosi_i),
        .I   (VSS), .OEN (VDD), .IE (VDD), .PE (VDD), .DS (VDD),
        .VDD (VDD), .VSS(VSS), .VDDPST(VDDPST), .VSSPST(VSSPST), .POC(POC)
    );

    // ---- miso, tri-state ----
    PRDW0812SCDG u_pad_miso (
        .PAD (pad_miso), .C (),
        .I   (miso_o), .OEN (miso_oen), .IE (VSS), .PE (VSS), .DS (VSS),
        .VDD (VDD), .VSS(VSS), .VDDPST(VDDPST), .VSSPST(VSSPST), .POC(POC)
    );

endmodule
