flowing-wind/SPI_Slave/(commit log)

2026-08-17 change pin place
2026-08-24 add the PPT and PDF in doc
    [high-z_demo.ms14, ssn_miso_demo.ms14]
